vaclav-bastl/PALM01/guiMockup.png

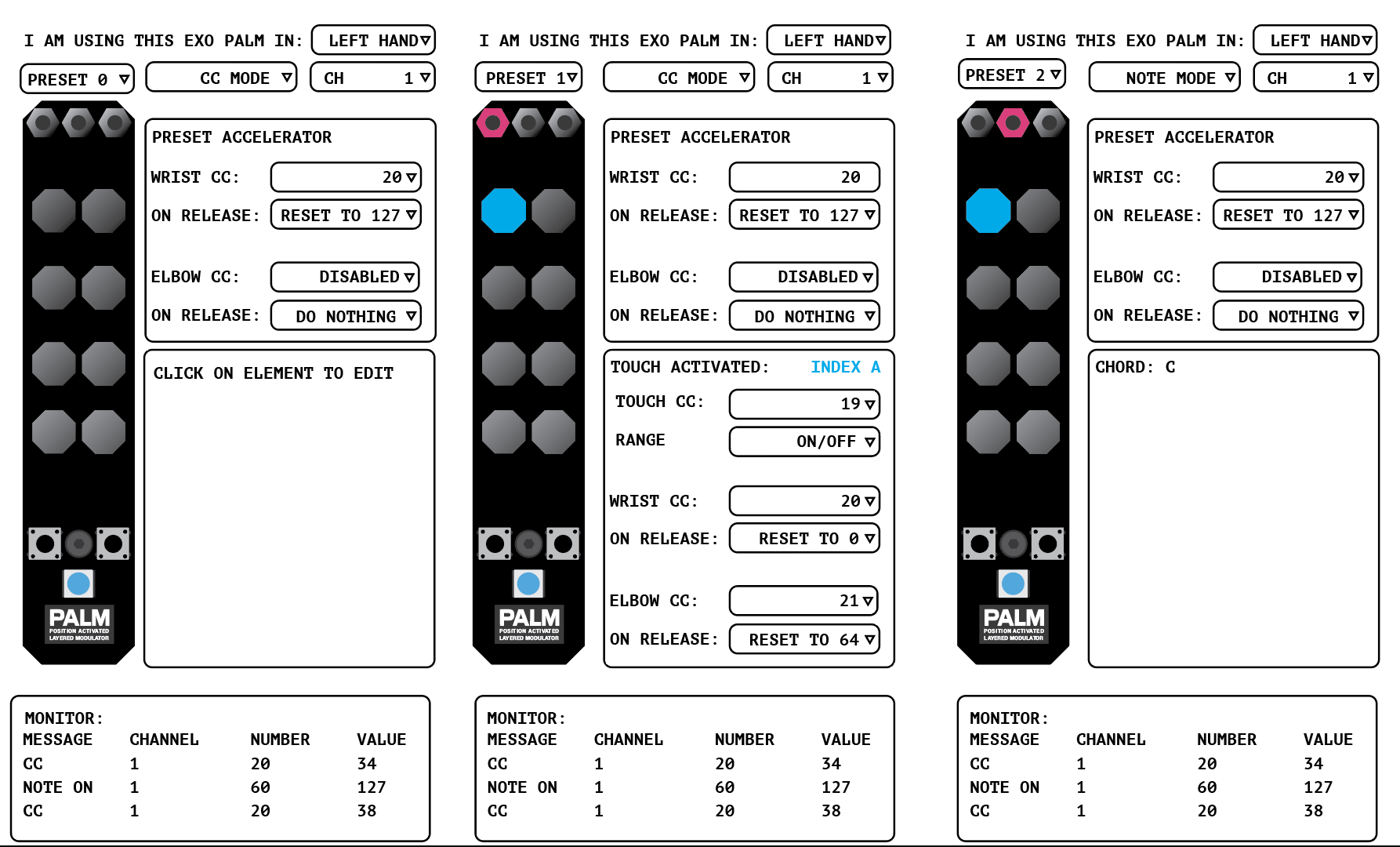
guiMockup.png
