vaclav-bastl/PALM01/overlay_Folder/Links/Snímek obrazovky 2025-07-29 v 12.03.49.png

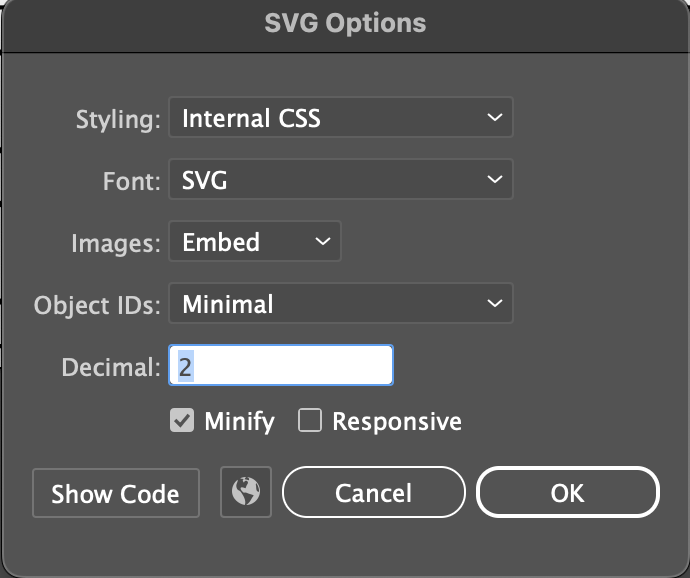
overlay_Folder/Links/Snímek obrazovky 2025-07-29 v 12.03.49.png
