vaclav-bastl/PALM01/schematics.png

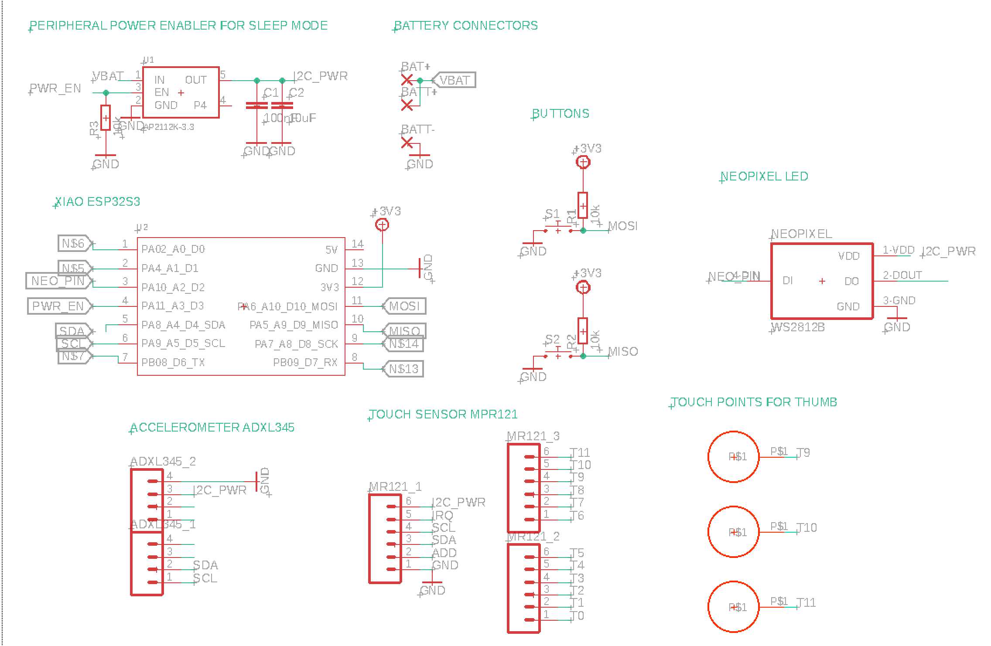
schematics.png
