vaclav-bastl/PALM01/vst-design/UImockup.png

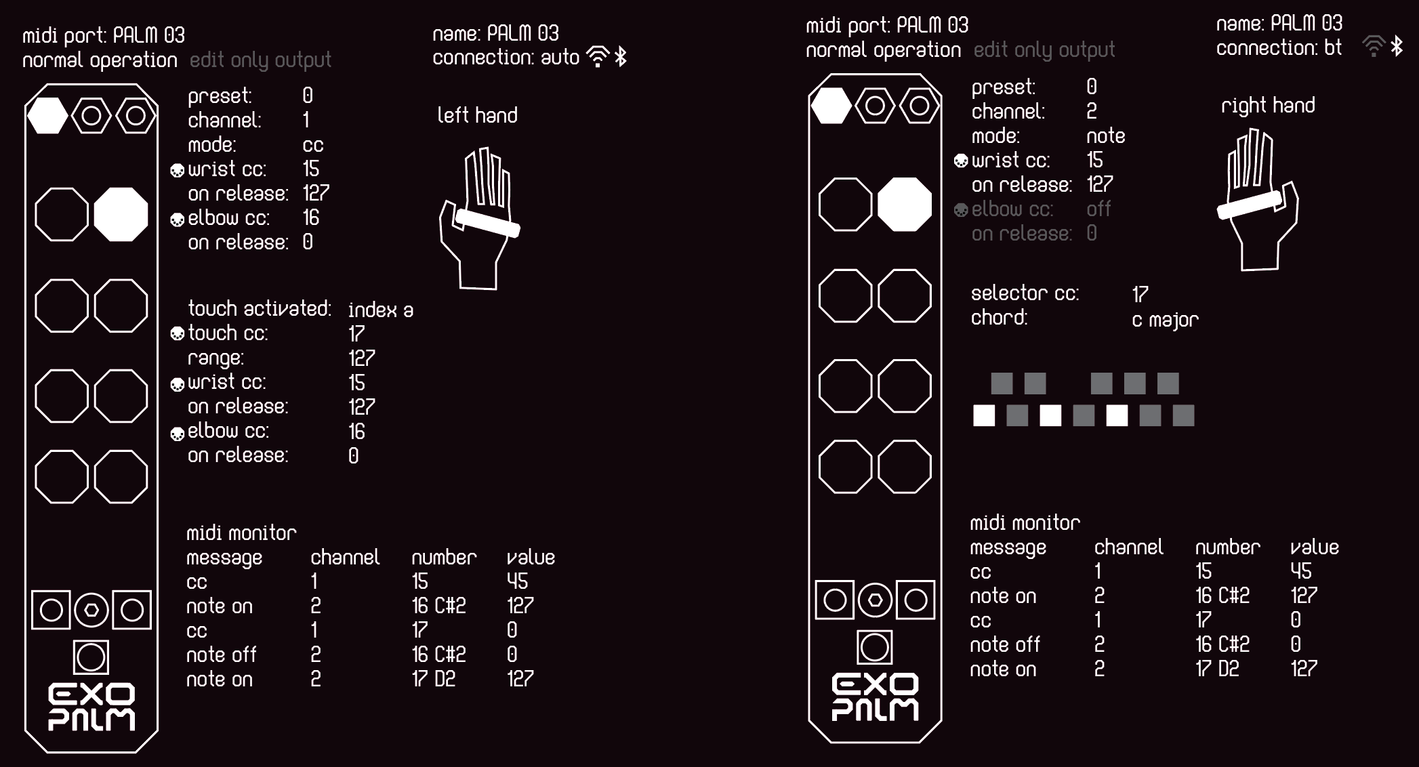
vst-design/UImockup.png
