vaclav-bastl/PALM01/palm.3mf

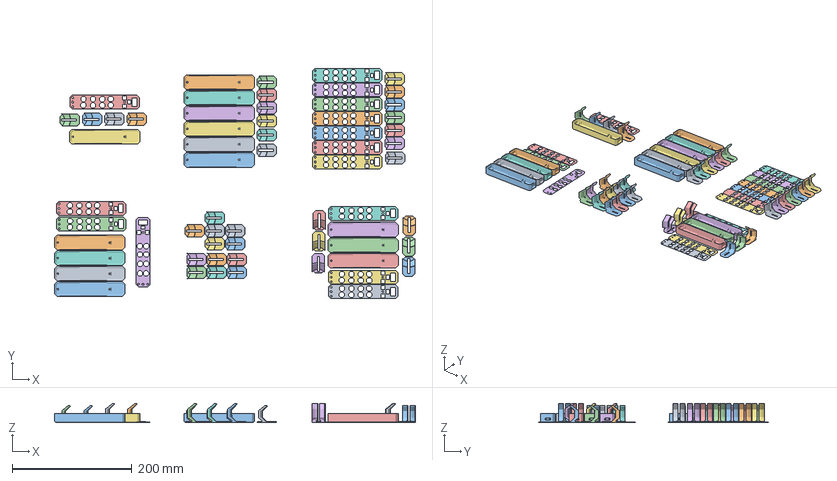
[picture p5: CAD file, 2025-09-16]
palm.3mf
601.7 x 383.6 x 32.5 mm
exoSideEvenBigger (1).stl x 18
exoSideBigger.stl x 17
overlay.stl x 14
case.stl x 14
