vaclav-bastl/PALM01/overlay.stl.stl

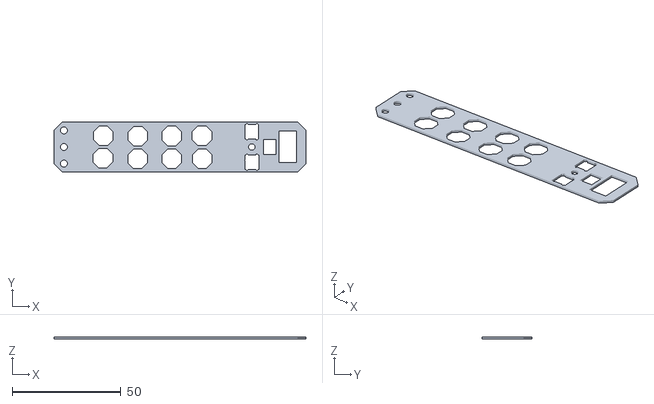
[picture p6: CAD file, 2025-07-29]
overlay.stl.stl
115.8 x 23.1 x 1
