vaclav-bastl/PALM01/case.stl.stl

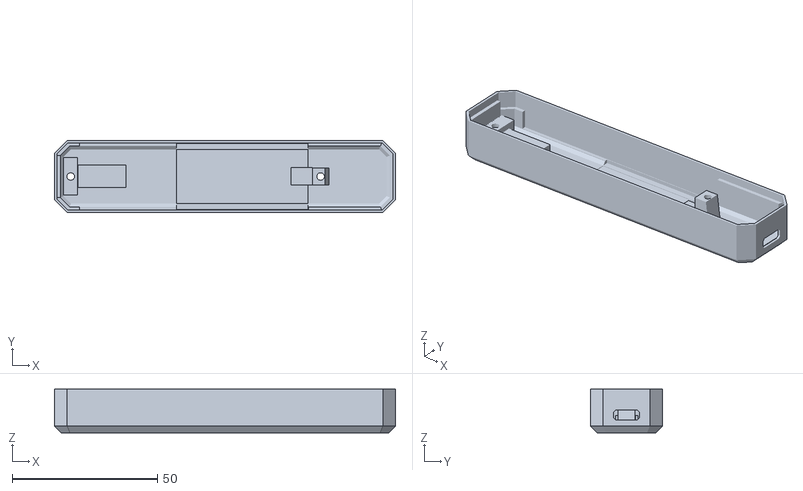
[picture p7: CAD file, 2025-07-29]
case.stl.stl
117.6 x 24.9 x 15.0
