vaclav-bastl/PALM01/exoSideEvenBigger.stl.stl

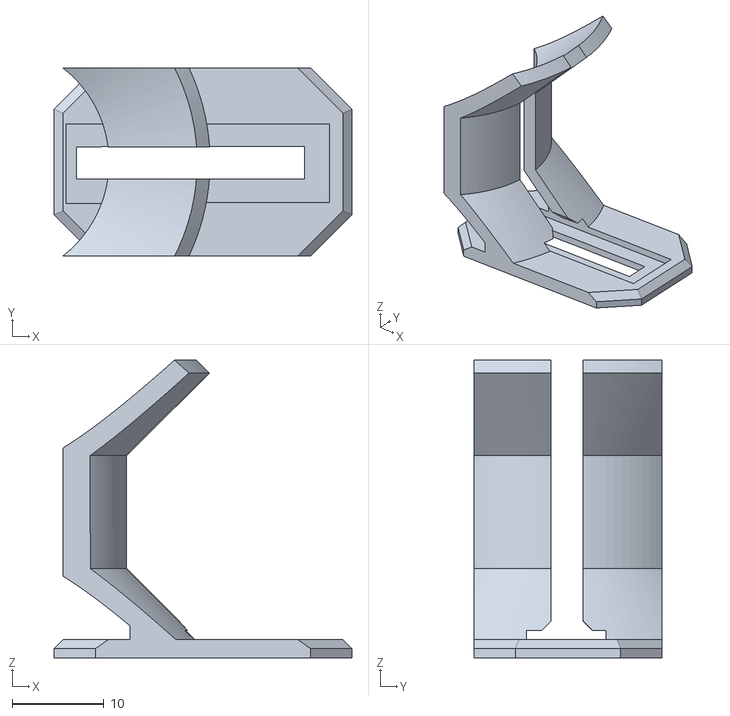
[picture p8: CAD file, 2025-07-29]
exoSideEvenBigger.stl.stl
32.5 x 20.5 x 32.5
