vaclav-bastl/PALM01/exoSideBigger.stl.stl

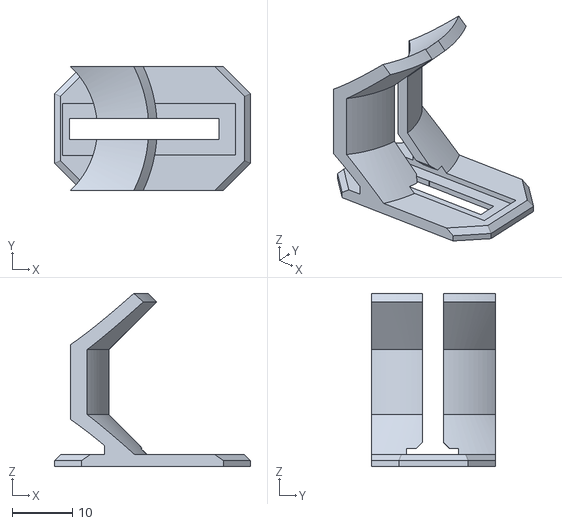
[picture p9: CAD file, 2025-07-29]
exoSideBigger.stl.stl
32.5 x 20.5 x 28.7
