vaclav-bastl/PALM01/(list of files, cad)

Other CAD files:
palm01 v15.f3z
