vaclav-bastl/PALM01/howTo3dPrintSVG.png

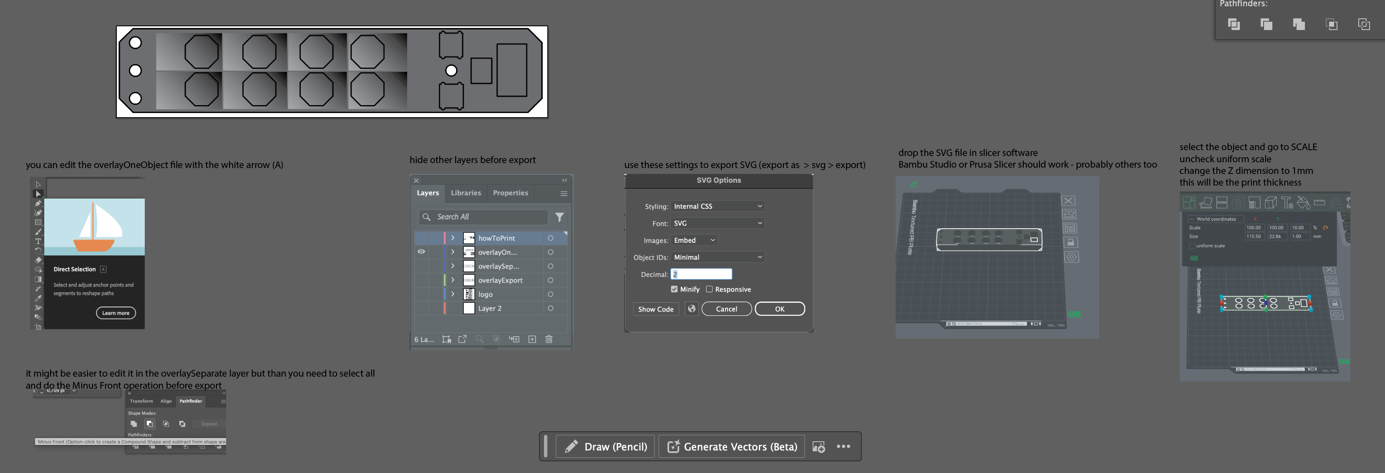
howTo3dPrintSVG.png
