vaclav-bastl/PALM01/PALM.brd

## EAGLE design PALM.brd (2025-07-29)

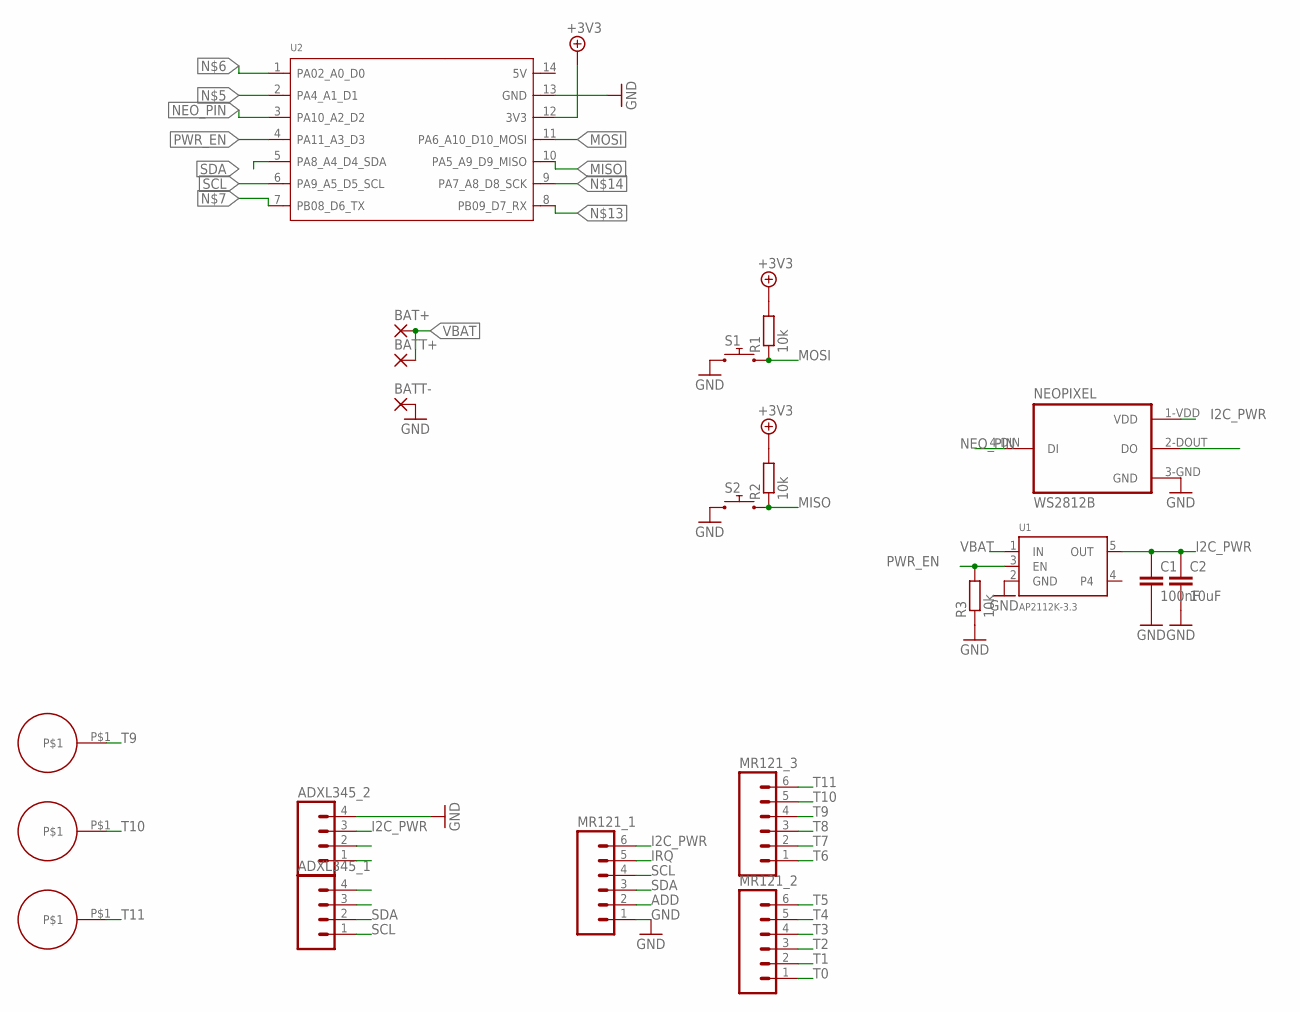
[picture p11: schematic PALM.sch]

Parts:
ADXL345_1, ADXL345_2: M04SMD_STRAIGHT_COMBO; 1X04_SMD_STRAIGHT_COMBO
BAT+: SMD2; SMD1,27-2,54
BATT+: SMD2; SMD1,27-2,54
BATT-: SMD2; SMD1,27-2,54
C1: 100nF; CAPACITOR0805
C2: 10uF; CAPACITOR0805
H2, H3, H4: FEROS_HEATHOLE; FEROS_HEATHOLE3.2
MR121_1, MR121_2, MR121_3: M06SMD-STRAIGHT-COMBO; 1X06_SMD_STRAIGHT_COMBO
NEOPIXEL: WS2812B
R1, R2, R3: 10k; 0805
S1, S2: PUSH_MOMENTARY_THT_6X6MM; TACTILE-PTH
U1: AP2112K-3.3; MICROBUILDER_SOT23-5
U2: MOUDLE-SEEEDUINO-XIAO-ESP32S3-SMD; MOUDLE14P-SMD-2.54-21X17.8MM

Connections:
+5V: R1.2, R2.2, U2.12 (3V3)
ADD: MR121_1.2
GND: ADXL345_2.4, BATT-.1, C1.2, C2.2, MR121_1.1, NEOPIXEL.3-GND (GND), R3.1, S1.1, S1.2 (1), S2.1, S2.2 (1), U1.2 (GND), U2.13 (GND)
I2C_PWR: ADXL345_2.3, C1.1, C2.1, MR121_1.6, NEOPIXEL.1-VDD (VDD), U1.5 (OUT)
IRQ: MR121_1.5
MISO: R2.1, S2.3 (2), S2.4 (2), U2.10 (PA5_A9_D9_MISO)
MOSI: R1.1, S1.3 (2), S1.4 (2), U2.11 (PA6_A10_D10_MOSI)
NEO_PIN: NEOPIXEL.4-DIN (DI), U2.3 (PA10_A2_D2)
PWR_EN: R3.2, U1.3 (EN), U2.4 (PA11_A3_D3)
SCL: ADXL345_1.1, MR121_1.4, U2.6 (PA9_A5_D5_SCL)
SDA: ADXL345_1.2, MR121_1.3, U2.5 (PA8_A4_D4_SDA)
T0: MR121_2.1
T1: MR121_2.2
T2: MR121_2.3
T3: MR121_2.4
T4: MR121_2.5
T5: MR121_2.6
T6: MR121_3.1
T7: MR121_3.2
T8: MR121_3.3
T9: H4.P$1, MR121_3.4
T10: H3.P$1, MR121_3.5
T11: H2.P$1, MR121_3.6
VBAT: BAT+.1, BATT+.1, U1.1 (IN)

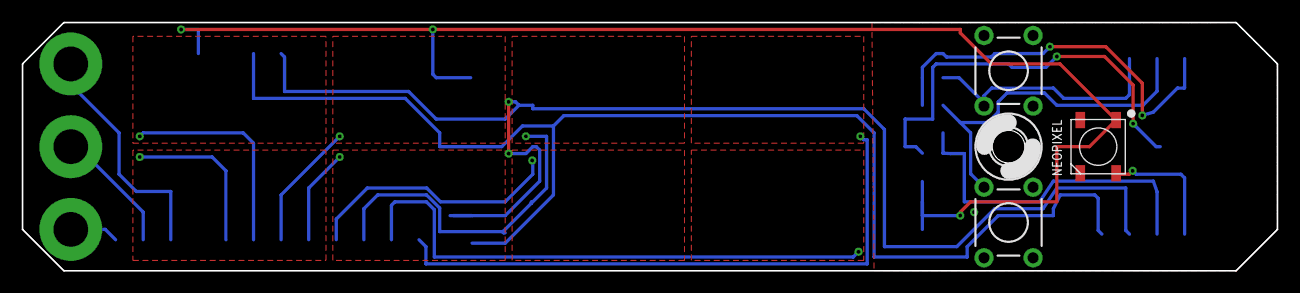
[picture p12: board PALM.brd from above]

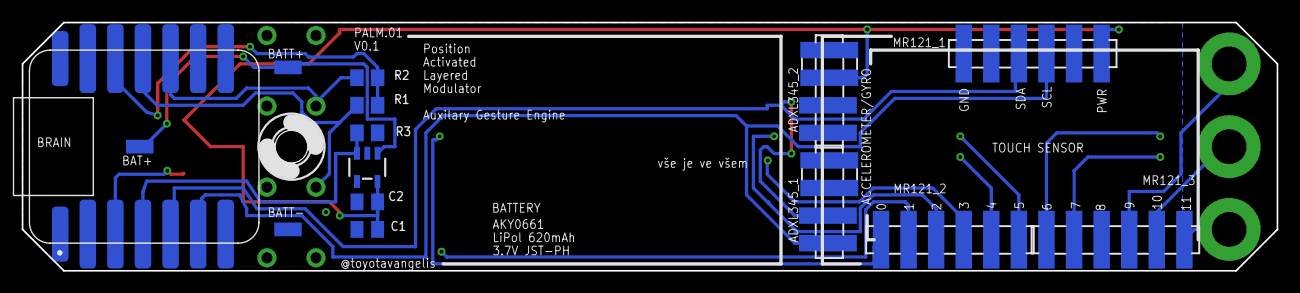
[picture p13: board PALM.brd from below]

Board: 2 copper layers, 115.6 x 22.9 mm, 22 parts (15 on the bottom side), 13 nets.

Other parts of the board:
H9: HOLE_3MM; 3MM_HOLE
