vaclav-bastl/PALM01/MPR121_AutoConfig_test/MPR121_AutoConfig_test.ino

/*********************************************************
This is a library for the MPR121 12-channel Capacitive touch sensor

Designed specifically to work with the MPR121 Breakout in the Adafruit shop 
  ----> https://www.adafruit.com/products/

These sensors use I2C communicate, at least 2 pins are required 
to interface

this sketch demonstrates the auto-config chip-funktionality.
for more information have a look at
https://github.com/adafruit/Adafruit_MPR121/issues/39
https://github.com/adafruit/Adafruit_MPR121/pull/43


based on MPR121test
modified & extended by Carter Nelson/caternuson

MIT license, all text above must be included in any redistribution
**********************************************************/
#include <Wire.h>
#include <Adafruit_MPR121.h>
#define I2C_POWER_PIN D3

#ifndef _BV
#define _BV(bit) (1 << (bit)) 
#endif

Adafruit_MPR121 cap = Adafruit_MPR121();

// Keeps track of the last pins touched
// so we know when buttons are 'released'
uint16_t lasttouched = 0;
uint16_t currtouched = 0;

void dump_regs() {
  Serial.println("========================================");
  Serial.println("CHAN 00 01 02 03 04 05 06 07 08 09 10 11");
  Serial.println("     -- -- -- -- -- -- -- -- -- -- -- --"); 
  // CDC
  Serial.print("CDC: ");
  for (int chan=0; chan<12; chan++) {
    uint8_t reg = cap.readRegister8(0x5F+chan);
    if (reg < 10) Serial.print(" ");
    Serial.print(reg);
    Serial.print(" ");
  }
  Serial.println();
  // CDT
  Serial.print("CDT: ");
  for (int chan=0; chan<6; chan++) {
    uint8_t reg = cap.readRegister8(0x6C+chan);
    uint8_t cdtx = reg & 0b111;
    uint8_t cdty = (reg >> 4) & 0b111;
    if (cdtx < 10) Serial.print(" ");
    Serial.print(cdtx);
    Serial.print(" ");
    if (cdty < 10) Serial.print(" ");
    Serial.print(cdty);
    Serial.print(" ");
  }
  Serial.println();
  Serial.println("========================================");
}

void setup() {
  pinMode(I2C_POWER_PIN, OUTPUT);
  digitalWrite(I2C_POWER_PIN, HIGH);
  delay(1000);
  Serial.begin(115200);
  while (!Serial);
  Serial.println("MPR121 Autoconfiguration Test. (MPR121-AutoConfig.ino)");
  
  Serial.println("startup `Wire`");
  Wire.begin();
  Serial.println("startup `Wire` done.");
  delay(100);
  
  Serial.println("cap.begin..");
  if (!cap.begin(0x5A, &Wire)) {
    Serial.println("MPR121 not found, check wiring?");
    while (1);
  }
  Serial.println("MPR121 found!");
  
  delay(100);

  Serial.println("Initial CDC/CDT values:");
  dump_regs();

  cap.setAutoconfig(true);

  Serial.println("After autoconfig CDC/CDT values:");
  dump_regs();
}

void loop() {
  // Get the currently touched pads
  currtouched = cap.touched();
  
  for (uint8_t i=0; i<12; i++) {
    // it if *is* touched and *wasnt* touched before, alert!
    if ((currtouched & _BV(i)) && !(lasttouched & _BV(i)) ) {
      Serial.print(i); Serial.println(" touched");
    }
    // if it *was* touched and now *isnt*, alert!
    if (!(currtouched & _BV(i)) && (lasttouched & _BV(i)) ) {
      Serial.print(i); Serial.println(" released");
    }
  }

  // reset our state
  lasttouched = currtouched;
}
