vaclav-bastl/PALM01/(commit log)

2025-07-31 fixed autoconfig and new calibration. added gerbers and slicer date
    [palm.3mf]
2025-09-16 added midi input parsing to the multi midi - tested it only on BLE so far
    [palm.3mf]
2025-10-11 better accelerometer filtering, no more out of range CC, preset cleanup, smarter preset switching, each finger priority is handeled based on leftHand=true
2025-10-11 added preset rotations and tried to do captive wifi (and failed)
    [PALM_01.ino, gyro.ino, hw.ino, midi.ino, palm_shared.h, touch.ino, utility.ino]
2025-10-26 added instructions for 3d printing svg for the overlay
2025-10-26 lower wifi power for lower heat emition. will probably drop more once running from 3V3 battery instead of 5V usb
2025-11-09 added velocity to the first touched note in note mode. also fixed non-reseting CC
    [PALM_01.ino, touch.ino]
2025-11-09 reset touch CCs when entering note mode + clip the touch velocity
    [PALM_01.ino, touch.ino]
2026-07-05 espnow: announce device name in PING for named receiver ports
    Same change as toyotaMicrophoneControler/exo_mic_rf 00ccc8a -- the
    wirelessToUSBmidi receiver now binds each transmitter to a named USB MIDI
    port keyed by this name (PALM_03).
    [espnow.ino]
2026-07-05 ble: advertise device name in scan response (same as exo_mic_rf)
2026-07-05 add exo_palm: refactored dual-transport firmware (ESP-NOW + BLE fallback)
    Topic-tab refactor of PALM_01 with arduino-cli/VS Code build, encrypted
    ESP-NOW link to the exohub receiver, BLE MIDI fallback, named-port
    discovery announce.
2026-07-05 ble-pin-pairing: force macOS passkey pairing on the MIDI characteristic
    READ/WRITE_AUTHEN+_ENC on the MIDI IO characteristic makes macOS hit an
    insufficient-authentication error on its spec-mandated read, triggering
    the passkey-entry dialog (123456) and a real bond for auto-reconnect.
    Secure Connections on; auth-result logging; BUTTON_L while disconnected
    wipes bonds. BLE-primary build (ESP-NOW disabled) for testing.
    [exo_palm.ino, midi.ino]
2026-07-05 ble-pin-pairing: final pairing recipe -- silent just-works bond, WIDI-parity
    Encryption-required (not authentication-required) MIDI characteristic +
    bond/SC/no-MITM: macOS pairs silently on connect (one confirmation
    dialog, no PIN) and registers the device in the system paired list,
    byte-identical to the reference CME WIDI Jack entry. Fresh static
    random address sidesteps weeks of stale GATT caches that caused
    connect/instant-drop loops. Unconditional connect/disconnect/auth
    logging kept.
    Findings: macOS 13.5+ BLE MIDI auto-connect is event-driven (boot/wake/
    activation), not a background scan -- the reference WIDI also fails a
    passive reconnect test. MIDIBluetoothDriverActivateAllConnectio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
    [midi.ino]
2026-07-05 ble-pin-pairing: directed advertising reconnect scheduler
    While bonded and disconnected, alternate directed advertising at the
    bonded central (8 s) with undirected advertising (4 s). Verified the
    directed bursts start and target the bonded Mac; macOS still does not
    auto-initiate BLE MIDI connections from radio triggers (control test:
    neither does the reference WIDI Jack). Kept because directed adv is
    what gets picked up fastest on Mac-side lifecycle events (wake/boot).
2026-07-05 ble-pin-pairing: WIDI presentation mimicry -> macOS auto-reconnect WORKS
    Full mimicry of the CME WIDI Jack's external presentation makes
    MIDIServer's 13.5+ auto-connect adopt the PALM: reconnects within
    seconds of power-on, unprompted, panel not required. Copied elements
    (bisection pending to find the honest minimum): Device Information
    Service with CME strings, CME manufacturer data (0x08250b) in the
    advertisement, 16-bit FFD0 service in scan response, no local name on
    the air (GATT name only), MIDI char props Read+WriteNR+Notify, fresh
    static address per GATT change.
    Proven by serial capture across a hard reset: boot -> advertise ->
    bond re-encrypt -> Mac connects, faster than CoreMIDI te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
    [midi.ino]
2026-07-05 ble-pin-pairing: FINAL honest recipe for macOS BLE MIDI auto-reconnect
    Apple's macOS 13.5+ BLE MIDI auto-connect (MIDIServer activate-all) is
    gated on device presentation COMPLETENESS, not brand: an honest Device
    Information Service (Bastl Instruments / PALM) + manufacturer data in
    the advertisement is sufficient. Local name in the scan response does
    not break it (restored -- also needed for exohub port binding).
    The complete recipe, all verified on hardware:
    - DIS 0x180A: manufacturer/model/firmware/hardware strings
    - manufacturer data AD field in the advertisement
    - silent just-works bond: ENC-gated MIDI characteristic (not AUTHEN),
    bond+SC+noMITM, NO_INPUT_OUTPUT
    - stable static random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
    [midi.ino]
2026-07-05 merge follow-up: ESP-NOW priority restored over the new BLE recipe
    Re-enable USE_ESPNOW_MIDI (the branch tested BLE-primary); BLE
    advertising stays quiet while the ESP-NOW receiver holds the link, so
    the exohub always wins when present and the WIDI-grade BLE fallback
    takes over only when it is not. Hunt-era ESP-NOW debug prints removed.
2026-07-06 fix left button: mapping mode works on any link, bond-wipe is a 5 s hold
    The mode cycle was gated on bleConnected (BLE-only era leftover), so
    with ESP-NOW priority the button appeared dead -- and the merged
    pairing-experiment gesture made every press while BLE-disconnected
    silently wipe the BLE bonds. Tap now always cycles the mapping mode
    (verified on hardware: 4 taps, 4 cycles); the bond wipe requires a
    deliberate 5 s hold. Presses log to serial.
    [exo_palm.ino]
2026-07-06 configurator firmware: NVS-backed config + SysEx protocol
    Presets move out of code into NVS: the tables in the main tab are now
    first-boot defaults, loaded/overwritten by config.ino at boot, edited
    live via sysex.ino, persisted on save. Device name joins them.
    SysEx protocol (F0 7D PLM, vst-design/DESIGN.md): device info, full
    dump, set-param (live), save, set-name, revert. Arrives over BLE
    (characteristic write callback added -- PALM's first BLE MIDI input
    parser) or the exohub ESP-NOW downstream; replies return on the same
    transport (spec-correct multi-packet BLE-MIDI SysEx / 8-byte ESP-NOW
    chunks). Verified end-to-end through the exohub: dump matches firmware
    defaults byte-for-byte, live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
    [config.ino, espnow.ino, exo_palm.ino, midi.ino, sysex.ino]
2026-07-06 configurator: JUCE scaffold, protocol client, palmcli -- verified live
    CMake project fetching JUCE 8 + clap-juce-extensions; builds VST3, AU,
    CLAP and Standalone (VST3 auto-installs). PalmProtocol (pure frame
    logic), PalmDevice (direct MIDI port access, exohub preferred over BLE,
    async replies), passthrough processor with config-in-session recall,
    and a phase-4 utility editor (port picker / dump / save / revert / log).
    palmcli console tool exercises the identical client code; verified
    against the live device through the exohub: info + full 218-byte dump
    matching the firmware tables byte-for-byte.
2026-07-06 configurator: phase 5 UI -- mockup layout, Eightgon LnF, per-finger editor, CC/NOTE modes, MIDI monitor
2026-07-06 configurator: mockup-faithful pass -- device silhouette, DIN icons, hand+strap, flat header, chord piano grid
2026-07-06 configurator + firmware: interactive device UI, MIDI-learn edit mode, per-root chords
    - preset thumb points + finger pads clickable (edit-preset / finger / chord root)
    - DIN icons send their CC to the plugin's MIDI out for DAW mapping
    - 'edit only output' = new SysEx 0x07: device mutes normal MIDI (RAM only)
    - double-click value entry; drag below min = off, above max = hang/gate
    - auto-connects to the first port with 'palm' in the name
    - note mode: editable per-root chord masks (finger bytes + 0x42 magic),
    firmware arpeggiates the mask instead of the fixed triad tables
    - resizable editor (fixed-aspect scaled canvas)
    [exo_palm.ino, midi.ino]
2026-07-06 configurator: interaction fixes -- connection probe, focus-out commits text box, single-click toggles
    - silent-port probe: if an opened 'palm' port never answers, close it and
    cycle to the next candidate (palm may be linked hub vs BLE) -- fixes the
    monitor looking dead while session-restored values masked a dead link
    - clicking anywhere outside an open value box commits it (focus-based)
    - DIN icon click sends the CC and opens the value box
    - mode row toggles cc/note on single click; 'normal operation' click
    leaves edit-only mode (hand toggle already single-click)
    - port list refresh keeps the connected port selected
